yuyuranium/ARC-AIoT-driver-feedback-system/img/IMG_2773.JPG

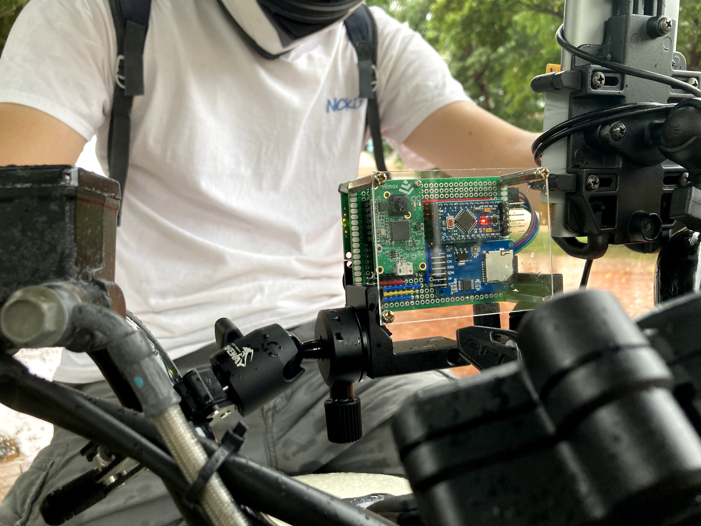
img/IMG_2773.JPG
