yuyuranium/ARC-AIoT-driver-feedback-system/img/IMG_2826.JPG

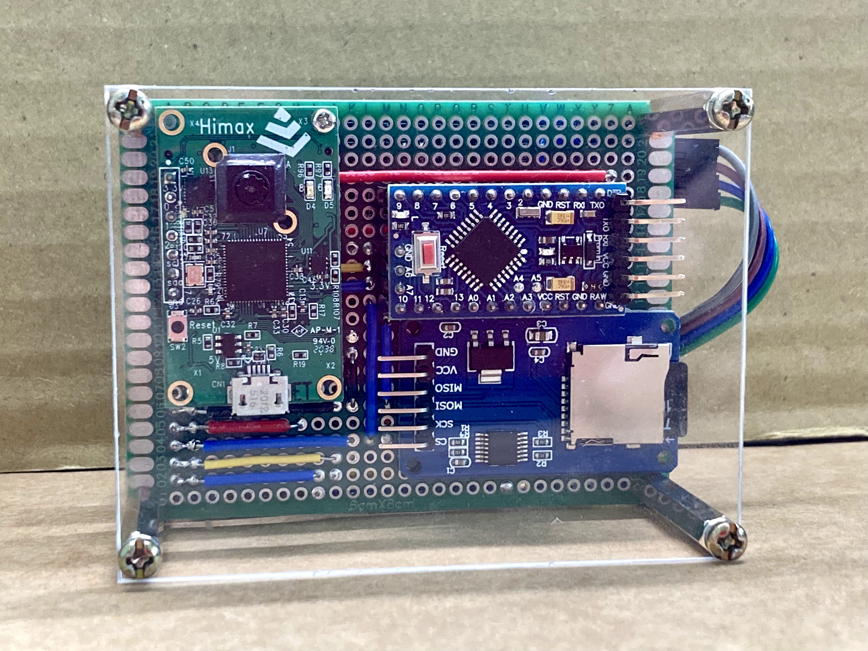
img/IMG_2826.JPG
