yuyuranium/ARC-AIoT-driver-feedback-system/himax_we1_evb/driver_feedback_system/inc/state_machine_handler.h

#ifndef STATE_MACHINE_HANDLER_H_
#define STATE_MACHINE_HANDLER_H_

#include "tensorflow/lite/c/common.h"
#include "tensorflow/lite/micro/micro_error_reporter.h"

extern int8_t StateTransition(int8_t motion);

#endif  // STATE_MACHINE_HANDLER_H_
