yuyuranium/ARC-AIoT-driver-feedback-system/himax_we1_evb/driver_feedback_system/inc/motion_detector.h

#ifndef MOTION_DETECTOR_H_
#define MOTION_DETECTOR_H_

#include "tensorflow/lite/micro/micro_error_reporter.h"

extern int SetDetectionThreshold(tflite::ErrorReporter* error_reporter,
                                 float confidence, uint32_t zero_point,
                                 float scale);
extern int8_t DetectMotion(int8_t *output);

#endif // MOTION_DETECTOR_H_
