yuyuranium/ARC-AIoT-driver-feedback-system/himax_we1_evb/driver_feedback_system/src/classifier_model.cc

unsigned char classifier_tflite[] = {
  0x1c, 0x00, 0x00, 0x00, 0x54, 0x46, 0x4c, 0x33, 0x14, 0x00, 0x20, 0x00,
  0x1c, 0x00, 0x18, 0x00, 0x14, 0x00, 0x10, 0x00, 0x0c, 0x00, 0x00, 0x00,
  0x08, 0x00, 0x04, 0x00, 0x14, 0x00, 0x00, 0x00, 0x1c, 0x00, 0x00, 0x00,
  0x1c, 0x00, 0x00, 0x00, 0x4c, 0x00, 0x00, 0x00, 0xac, 0x15, 0x00, 0x00,
  0xbc, 0x15, 0x00, 0x00, 0x40, 0x5a, 0x00, 0x00, 0x03, 0x00, 0x00, 0x00,
  0x00, 0x00, 0x00, 0x00, 0x01, 0x00, 0x00, 0x00, 0x0c, 0x00, 0x00, 0x00,
  0x08, 0x00, 0x0c, 0x00, 0x08, 0x00, 0x04, 0x00, 0x08, 0x00, 0x00, 0x00,
  0x67, 0x00, 0x00, 0x00, 0x04, 0x00, 0x00, 0x00, 0x13, 0x00, 0x00, 0x00,
  0x6d, 0x69, 0x6e, 0x5f, 0x72, 0x75, 0x6e, 0x74, 0x69, 0x6d, 0x65, 0x5f,
  0x76, 0x65, 0x72, 0x73, 0x69, 0x6f, 0x6e, 0x00, 0x68, 0x00, 0x00, 0x00,
  0x5c, 0x15, 0x00, 0x00, 0x54, 0x15, 0x00, 0x00, 0x34, 0x15, 0x00, 0x00,
  0x18, 0x15, 0x00, 0x00, 0xfc, 0x14, 0x00, 0x00, 0xdc, 0x14, 0x00, 0x00,
  0xbc, 0x14, 0x00, 0x00, 0x9c, 0x14, 0x00, 0x00, 0x84, 0x14, 0x00, 0x00,
  0x6c, 0x14, 0x00, 0x00, 0x58, 0x14, 0x00, 0x00, 0x44, 0x14, 0x00, 0x00,
  0x30, 0x14, 0x00, 0x00, 0xb0, 0x13, 0x00, 0x00, 0x90, 0x13, 0x00, 0x00,
  0x70, 0x13, 0x00, 0x00, 0x50, 0x13, 0x00, 0x00, 0x30, 0x13, 0x00, 0x00,
  0x10, 0x13, 0x00, 0x00, 0xf0, 0x12, 0x00, 0x00, 0xd0, 0x12, 0x00, 0x00,
  0xb0, 0x12, 0x00, 0x00, 0x90, 0x12, 0x00, 0x00, 0x70, 0x12, 0x00, 0x00,
  0x50, 0x12, 0x00, 0x00, 0x30, 0x12, 0x00, 0x00, 0xe8, 0x11, 0x00, 0x00,
  0xbc, 0x11, 0x00, 0x00, 0x4c, 0x11, 0x00, 0x00, 0xfc, 0x10, 0x00, 0x00,
  0xd4, 0x10, 0x00, 0x00, 0xb4, 0x10, 0x00, 0x00, 0x94, 0x10, 0x00, 0x00,
  0x74, 0x10, 0x00, 0x00, 0xf4, 0x0f, 0x00, 0x00, 0xac, 0x0f, 0x00, 0x00,
  0x80, 0x0f, 0x00, 0x00, 0x30, 0x0f, 0x00, 0x00, 0x10, 0x0f, 0x00, 0x00,
  0xf0, 0x0e, 0x00, 0x00, 0xd0, 0x0e, 0x00, 0x00, 0x50, 0x0e, 0x00, 0x00,
  0x08, 0x0e, 0x00, 0x00, 0xdc, 0x0d, 0x00, 0x00, 0x8c, 0x0d, 0x00, 0x00,
  0x6c, 0x0d, 0x00, 0x00, 0x4c, 0x0d, 0x00, 0x00, 0xfc, 0x01, 0x00, 0x00,
  0xd4, 0x01, 0x00, 0x00, 0xcc, 0x01, 0x00, 0x00, 0xc4, 0x01, 0x00, 0x00,
  0xbc, 0x01, 0x00, 0x00, 0xb4, 0x01, 0x00, 0x00, 0xac, 0x01, 0x00, 0x00,
  0xa4, 0x01, 0x00, 0x00, 0x9c, 0x01, 0x00, 0x00, 0x94, 0x01, 0x00, 0x00,
  0x8c, 0x01, 0x00, 0x00, 0x84, 0x01, 0x00, 0x00, 0x7c, 0x01, 0x00, 0x00,
  0x74, 0x01, 0x00, 0x00, 0x6c, 0x01, 0x00, 0x00, 0x64, 0x01, 0x00, 0x00,
  0x5c, 0x01, 0x00, 0x00, 0x54, 0x01, 0x00, 0x00, 0x4c, 0x01, 0x00, 0x00,
  0x44, 0x01, 0x00, 0x00, 0x3c, 0x01, 0x00, 0x00, 0x34, 0x01, 0x00, 0x00,
  0x2c, 0x01, 0x00, 0x00, 0x24, 0x01, 0x00, 0x00, 0x1c, 0x01, 0x00, 0x00,
  0x14, 0x01, 0x00, 0x00, 0x0c, 0x01, 0x00, 0x00, 0x04, 0x01, 0x00, 0x00,
  0xfc, 0x00, 0x00, 0x00, 0xf4, 0x00, 0x00, 0x00, 0xec, 0x00, 0x00, 0x00,
  0xe4, 0x00, 0x00, 0x00, 0xdc, 0x00, 0x00, 0x00, 0xd4, 0x00, 0x00, 0x00,
  0xcc, 0x00, 0x00, 0x00, 0xc4, 0x00, 0x00, 0x00, 0xbc, 0x00, 0x00, 0x00,
  0xb4, 0x00, 0x00, 0x00, 0xac, 0x00, 0x00, 0x00, 0xa4, 0x00, 0x00, 0x00,
  0x9c, 0x00, 0x00, 0x00, 0x94, 0x00, 0x00, 0x00, 0x8c, 0x00, 0x00, 0x00,
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
};
unsigned int classifier_tflite_len = 23352;
