yuyuranium/ARC-AIoT-driver-feedback-system/himax_we1_evb/driver_feedback_system/src/predictor_model.cc

unsigned char predictor_tflite[] = {
  0x1c, 0x00, 0x00, 0x00, 0x54, 0x46, 0x4c, 0x33, 0x14, 0x00, 0x20, 0x00,
  0x1c, 0x00, 0x18, 0x00, 0x14, 0x00, 0x10, 0x00, 0x0c, 0x00, 0x00, 0x00,
  0x08, 0x00, 0x04, 0x00, 0x14, 0x00, 0x00, 0x00, 0x1c, 0x00, 0x00, 0x00,
  0x1c, 0x00, 0x00, 0x00, 0x4c, 0x00, 0x00, 0x00, 0x20, 0x0c, 0x00, 0x00,
  0x30, 0x0c, 0x00, 0x00, 0x74, 0x20, 0x00, 0x00, 0x03, 0x00, 0x00, 0x00,
  0x00, 0x00, 0x00, 0x00, 0x01, 0x00, 0x00, 0x00, 0x0c, 0x00, 0x00, 0x00,
  0x08, 0x00, 0x0c, 0x00, 0x08, 0x00, 0x04, 0x00, 0x08, 0x00, 0x00, 0x00,
  0x20, 0x00, 0x00, 0x00, 0x04, 0x00, 0x00, 0x00, 0x13, 0x00, 0x00, 0x00,
  0x6d, 0x69, 0x6e, 0x5f, 0x72, 0x75, 0x6e, 0x74, 0x69, 0x6d, 0x65, 0x5f,
  0x76, 0x65, 0x72, 0x73, 0x69, 0x6f, 0x6e, 0x00, 0x21, 0x00, 0x00, 0x00,
  0xd0, 0x0b, 0x00, 0x00, 0xc8, 0x0b, 0x00, 0x00, 0xa8, 0x0b, 0x00, 0x00,
  0x80, 0x0b, 0x00, 0x00, 0x60, 0x0b, 0x00, 0x00, 0x40, 0x0b, 0x00, 0x00,
  0x28, 0x0b, 0x00, 0x00, 0x28, 0x0a, 0x00, 0x00, 0x08, 0x0a, 0x00, 0x00,
  0x58, 0x09, 0x00, 0x00, 0x38, 0x09, 0x00, 0x00, 0x88, 0x08, 0x00, 0x00,
  0x68, 0x08, 0x00, 0x00, 0x58, 0x06, 0x00, 0x00, 0x48, 0x05, 0x00, 0x00,
  0x38, 0x01, 0x00, 0x00, 0xe8, 0x00, 0x00, 0x00, 0xa8, 0x00, 0x00, 0x00,
  0x8c, 0x00, 0x00, 0x00, 0x84, 0x00, 0x00, 0x00, 0x7c, 0x00, 0x00, 0x00,
  0x74, 0x00, 0x00, 0x00, 0x6c, 0x00, 0x00, 0x00, 0x64, 0x00, 0x00, 0x00,
  0x5c, 0x00, 0x00, 0x00, 0x54, 0x00, 0x00, 0x00, 0x4c, 0x00, 0x00, 0x00,
  0x44, 0x00, 0x00, 0x00, 0x3c, 0x00, 0x00, 0x00, 0x34, 0x00, 0x00, 0x00,
  0x2c, 0x00, 0x00, 0x00, 0x24, 0x00, 0x00, 0x00, 0x04, 0x00, 0x00, 0x00,
  0xda, 0xf4, 0xff, 0xff, 0x04, 0x00, 0x00, 0x00, 0x10, 0x00, 0x00, 0x00,
  0x31, 0x2e, 0x31, 0x34, 0x2e, 0x30, 0x00, 0x00, 0x00, 0x00, 0x00, 0x00,
  0x00, 0x00, 0x00, 0x00, 0x34, 0xe1, 0xff, 0xff, 0x38, 0xe1, 0xff, 0xff,
  0x3c, 0xe1, 0xff, 0xff, 0x40, 0xe1, 0xff, 0xff, 0x44, 0xe1, 0xff, 0xff,
  0x48, 0xe1, 0xff, 0xff, 0x4c, 0xe1, 0xff, 0xff, 0x50, 0xe1, 0xff, 0xff,
  0x54, 0xe1, 0xff, 0xff, 0x58, 0xe1, 0xff, 0xff, 0x5c, 0xe1, 0xff, 0xff,
  0x60, 0xe1, 0xff, 0xff, 0x64, 0xe1, 0xff, 0xff, 0x2a, 0xf5, 0xff, 0xff,
  0x04, 0x00, 0x00, 0x00, 0x0c, 0x00, 0x00, 0x00, 0xc9, 0x00, 0x00, 0x00,
  0x33, 0x00, 0x00, 0x00, 0x3e, 0x01, 0x00, 0x00, 0x42, 0xf5, 0xff, 0xff,
  0x04, 0x00, 0x00, 0x00, 0x30, 0x00, 0x00, 0x00, 0x87, 0x5f, 0x4b, 0x7d,
  0xe2, 0x90, 0xdc, 0xa5, 0x3d, 0xc1, 0xbf, 0x03, 0x2a, 0xe7, 0x34, 0xe7,
  0x31, 0x7e, 0xaf, 0x00, 0xfe, 0xed, 0xd0, 0xc3, 0x81, 0xbc, 0x92, 0x64,
  0xab, 0xde, 0x23, 0x28, 0x7c, 0xee, 0x62, 0x53, 0xe3, 0xd1, 0xb9, 0xcb,
  0x62, 0x91, 0x2e, 0x87, 0x1b, 0x2a, 0x8e, 0x39, 0x7e, 0xf5, 0xff, 0xff,
  0x04, 0x00, 0x00, 0x00, 0x40, 0x00, 0x00, 0x00, 0x27, 0x02, 0x00, 0x00,
  0x81, 0x01, 0x00, 0x00, 0x05, 0x02, 0x00, 0x00, 0xa9, 0x02, 0x00, 0x00,
  0x07, 0xfd, 0xff, 0xff, 0x57, 0xfd, 0xff, 0xff, 0x05, 0xfd, 0xff, 0xff,
  0x9b, 0xfc, 0xff, 0xff, 0xe2, 0x01, 0x00, 0x00, 0xc3, 0xfc, 0xff, 0xff,
  0xbb, 0xff, 0xff, 0xff, 0x31, 0xfe, 0xff, 0xff, 0x49, 0x01, 0x00, 0x00,
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
};
unsigned int predictor_tflite_len = 8464;
