yuyuranium/ARC-AIoT-driver-feedback-system/himax_we1_evb/driver_feedback_system/inc/main_functions.h

#ifndef MAIN_FUNCTIONS_H_
#define MAIN_FUNCTIONS_H_

// Expose a C friendly interface for main functions.
#ifdef __cplusplus
extern "C" {
#endif

void Setup();
void Inference();

#ifdef __cplusplus
}
#endif

#endif  // MAIN_FUNCTIONS_H_
