yuyuranium/ARC-AIoT-driver-feedback-system/himax_we1_evb/driver_feedback_system/inc/i2c_output_handler.h

#ifndef I2C_OUTPUT_HANDLER_H_
#define I2C_OUTPUT_HANDLER_H_

#include "tensorflow/lite/c/common.h"
#include "tensorflow/lite/micro/micro_error_reporter.h"

extern TfLiteStatus SetupI2C(tflite::ErrorReporter* error_reporter);
extern TfLiteStatus I2CSendOutput(int8_t *output, int length);

#endif  // I2C_OUTPUT_HANDLER_H_
