yuyuranium/ARC-AIoT-driver-feedback-system/(commit log)

2021-05-29 Add training codes
    [1.CSV, 10.CSV, 11.CSV, 12.CSV, 13.CSV, 14.CSV, 15.CSV, 16.CSV]
2021-05-29 Rename filename and add detection resolver
    [i2c_slave_data_collecter.ino, i2c_slave_motion_detection_4_class_resolver.ino]
2021-05-30 Remove training data and modify .gitignore
    [1.CSV, 10.CSV, 11.CSV, 12.CSV, 13.CSV, 14.CSV, 15.CSV, 16.CSV]
2021-07-07 Fix typo, revise implicit ovf warning
    [bt_master_label_controller.ino]
2021-07-09 Modify pin outs after soldering all components on the prototyping board
2021-07-19 Update for testing two models, add data transmission using I2C
2021-07-21 Add arduino program for recieving output from himax
2021-07-22 Update arduino data resolver to recieve state information
    [i2c_slave_motion_detection_6_class_with_prediction_resolver.ino]
2021-07-23 Add error evaluation handler and update inference parameters
    [accelerometer_handler.cc, accelerometer_handler.h, constants.h, error_evaluation_handler.cc, error_evaluation_handler.h, i2c_output_handler.cc, i2c_output_handler.h, main_functions.cc]
2021-07-24 Add arduino code to resolve the inference result
    [driver_feedback_system.ino, i2c_slave_motion_detection_6_class_with_prediction_resolver.ino]
2021-07-24 Update for i2c communication with arduino
2021-08-01 Speed up sampling rate to 40Hz
2021-08-03 Speed up sampling rate and add calibration function
2021-08-03 Update calibration function for testing
2021-08-04 Optimize Arduino codes for testing new model
2021-08-06 Update Arduino code for final
2021-08-07 Update and optimize Arduino codes
